Ulf-vom-Mond/ofen/electronics/ofen.kicad_pcb

## KiCad design electronics/ofen.kicad_pcb (2021-03-20)

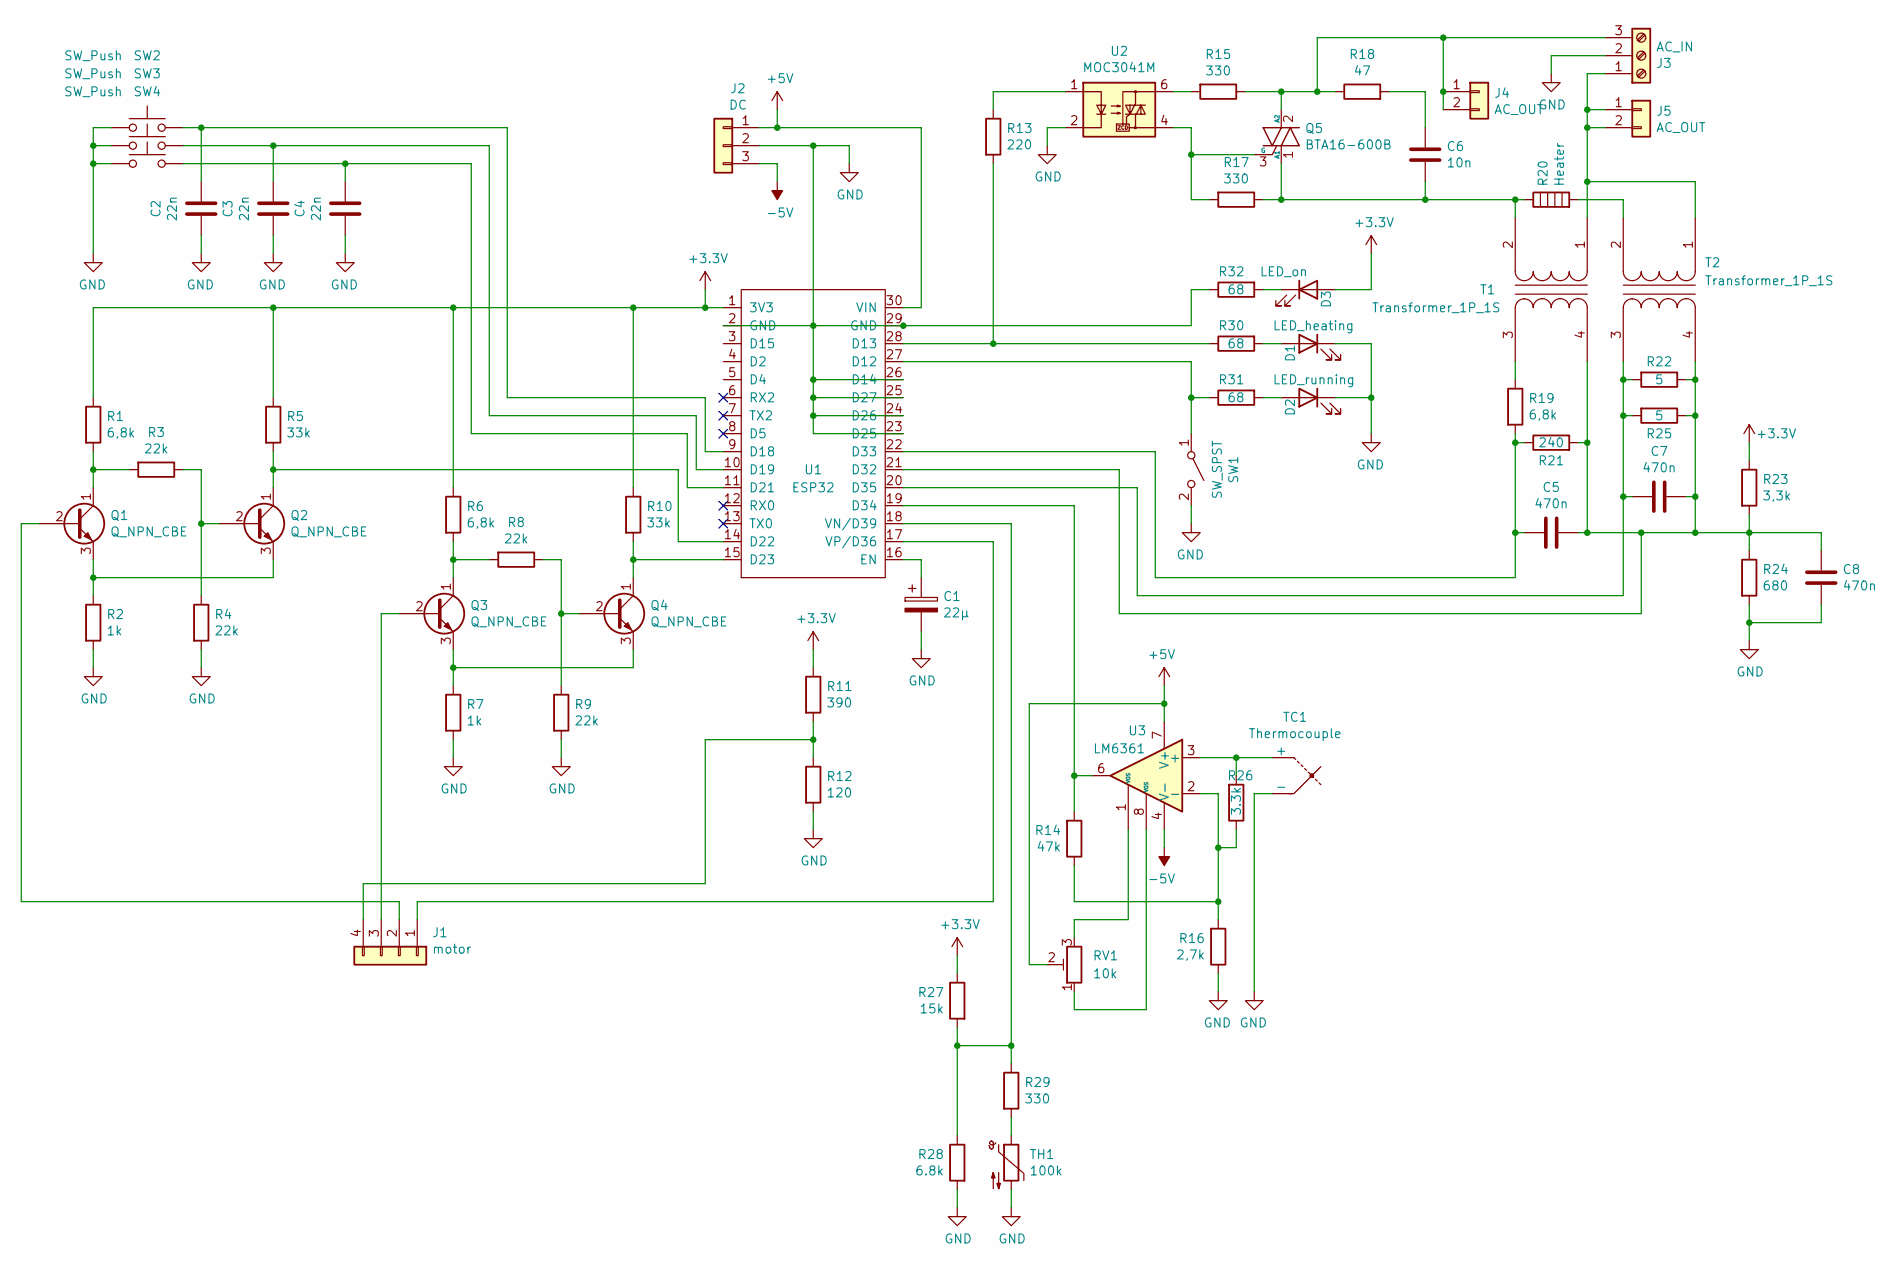
[picture p1: schematic ofen.sch]

Parts:
C1: 22µ; CP_Radial_D6.3mm_P2.50mm
C2, C3, C4: 22n; C_Disc_D4.3mm_W1.9mm_P5.00mm
C5, C7, C8: 470n; C_Rect_L7.0mm_W4.5mm_P5.00mm
C6: 10n; C_Rect_L11.5mm_W3.5mm_P10.00mm_MKT
D1: LED_heating; PinHeader_1x02_P2.54mm_Vertical
D2: LED_running; PinHeader_1x02_P2.54mm_Vertical
D3: LED_on; PinHeader_1x02_P2.54mm_Vertical
J1: motor; PinHeader_1x04_P2.54mm_Vertical
J2: DC; PinHeader_1x03_P2.54mm_Vertical
J3: AC_IN; TerminalBlock_Altech_AK300-3_P5.00mm
J4, J5: AC_OUT; SolderWire-0.75sqmm_1x02_P4.8mm_D1.25mm_OD2.3mm
Q1, Q2, Q3, Q4: Q_NPN_CBE; TO-92L_Inline_Wide
Q5: BTA16-600B; SolderWire-0.75sqmm_1x03_P4.8mm_D1.25mm_OD2.3mm
R1, R6, R19: 6,8k; R_Axial_DIN0207_L6.3mm_D2.5mm_P10.16mm_Horizontal
R2, R7: 1k; R_Axial_DIN0207_L6.3mm_D2.5mm_P10.16mm_Horizontal
R3, R4, R8, R9: 22k; R_Axial_DIN0207_L6.3mm_D2.5mm_P10.16mm_Horizontal
R5, R10: 33k; R_Axial_DIN0207_L6.3mm_D2.5mm_P10.16mm_Horizontal
R11: 390; R_Axial_DIN0207_L6.3mm_D2.5mm_P10.16mm_Horizontal
R12: 120; R_Axial_DIN0207_L6.3mm_D2.5mm_P10.16mm_Horizontal
R13: 220; R_Axial_DIN0207_L6.3mm_D2.5mm_P10.16mm_Horizontal
R14: 47k; R_Axial_DIN0207_L6.3mm_D2.5mm_P10.16mm_Horizontal
R15, R17, R29: 330; R_Axial_DIN0207_L6.3mm_D2.5mm_P10.16mm_Horizontal
R16: 2,7k; R_Axial_DIN0207_L6.3mm_D2.5mm_P10.16mm_Horizontal
R18: 47; R_Axial_DIN0207_L6.3mm_D2.5mm_P10.16mm_Horizontal
R20: Heater; TerminalBlock_Altech_AK300-3_P5.00mm
R21: 240; R_Axial_DIN0207_L6.3mm_D2.5mm_P10.16mm_Horizontal
R22, R25: 5; R_Axial_DIN0207_L6.3mm_D2.5mm_P10.16mm_Horizontal
R23: 3,3k; R_Axial_DIN0207_L6.3mm_D2.5mm_P10.16mm_Horizontal
R24: 680; R_Axial_DIN0207_L6.3mm_D2.5mm_P10.16mm_Horizontal
R26: 3.3k; R_Axial_DIN0207_L6.3mm_D2.5mm_P10.16mm_Horizontal
R27: 15k; R_Axial_DIN0207_L6.3mm_D2.5mm_P10.16mm_Horizontal
R28: 6.8k; R_Axial_DIN0207_L6.3mm_D2.5mm_P10.16mm_Horizontal
R30, R31, R32: 68; R_Axial_DIN0207_L6.3mm_D2.5mm_P10.16mm_Horizontal
RV1: 10k; Potentiometer_Bourns_3296W_Vertical
SW1: SW_SPST; PinHeader_1x02_P2.54mm_Vertical
SW2, SW3, SW4: SW_Push; PinHeader_1x02_P2.54mm_Vertical
T1, T2: Transformer_1P_1S; SolderWire-0.75sqmm_1x04_P4.8mm_D1.25mm_OD2.3mm
TC1: Thermocouple; PinHeader_1x02_P2.54mm_Vertical
TH1: 100k; PinHeader_1x02_P2.54mm_Vertical
U1: ESP32; ESP32-DevModule
U2: MOC3041M; DIP-6_W7.62mm_Socket_LongPads
U3: LM6361; DIP-8_W7.62mm_Socket_LongPads

Connections:
+3V3: D3.2 (A), R1.1, R5.1, R6.1, R10.1, R11.1, R23.1, R27.1, U1.1 (3V3)
+5V: J2.1, RV1.2, U1.30 (VIN), U3.7 (V+)
-5V: J2.3, U3.4 (V-)
GND: C1.2, C2.1, C3.1, C4.1, C8.1, D1.1 (K), D2.1 (K), J2.2, J3.2, R2.2, R4.2, R7.2, R9.2, R12.2, R16.1, R24.2, R28.2, R32.1, SW1.2 (B), SW2.2, SW3.2, SW4.2, TC1.2 (-), TH1.2, U1.2 (GND), U1.23 (D25), U1.24 (D26), U1.25 (D27), U1.26 (D14), U1.29 (GND), U2.2; also elsewhere on the board
unnamed: C1.1, U1.16 (EN)
unnamed: C2.2, SW2.1, U1.9 (D18)
unnamed: C3.2, SW3.1, U1.10 (D19)
unnamed: C4.2, SW4.1, U1.11 (D21)
unnamed: C5.1, C7.1, C8.2, R21.2, R22.1, R23.2, R24.1, R25.1, T1.4 (SB), T2.4 (SB), U1.21 (D32)
unnamed: C5.2, R19.2, R21.1, U1.22 (D33)
unnamed: C6.1, R18.2
unnamed: C6.2, Q5.1 (A1), R17.1, R20.1, T1.2 (AB)
unnamed: C7.2, R22.2, R25.2, T2.3 (SA), U1.20 (D35)
unnamed: D1.2 (A), R30.2
unnamed: D2.2 (A), R31.2
unnamed: D3.1 (K), R32.2
unnamed: J1.1, U1.17 (VP/D36)
unnamed: J1.2, Q1.2 (B)
unnamed: J1.3, Q3.2 (B)
unnamed: J1.4, R11.2, R12.1
unnamed: J3.1, J5.1, J5.2, T1.1 (AA), T2.1 (AA)
unnamed: J3.3, J4.1, J4.2, Q5.2 (A2), R15.1, R18.1
unnamed: Q1.1 (C), R1.2, R3.2
unnamed: Q1.3 (E), Q2.3 (E), R2.1
unnamed: Q2.1 (C), R5.2, U1.14 (D22)
unnamed: Q2.2 (B), R3.1, R4.1
unnamed: Q3.1 (C), R6.2, R8.2
unnamed: Q3.3 (E), Q4.3 (E), R7.1
unnamed: Q4.1 (C), R10.2, U1.15 (D23)
unnamed: Q4.2 (B), R8.1, R9.1
unnamed: Q5.3 (G), R17.2, U2.4
unnamed: R13.1, U2.1
unnamed: R13.2, R30.1, U1.28 (D13)
unnamed: R14.1, R16.2, R26.1, U3.2 (-)
unnamed: R14.2, U1.19 (D34), U3.6
unnamed: R15.2, U2.6
unnamed: R19.1, T1.3 (SA)
unnamed: R20.2, T2.2 (AB)
unnamed: R26.2, TC1.1 (+), U3.3 (+)
unnamed: R27.2, R28.1, R29.1, U1.18 (VN/D39)
unnamed: R29.2, TH1.1
unnamed: R31.1, SW1.1 (A), U1.27 (D12)
unnamed: RV1.1, U3.8 (VOS)
unnamed: RV1.3, U3.1 (VOS)

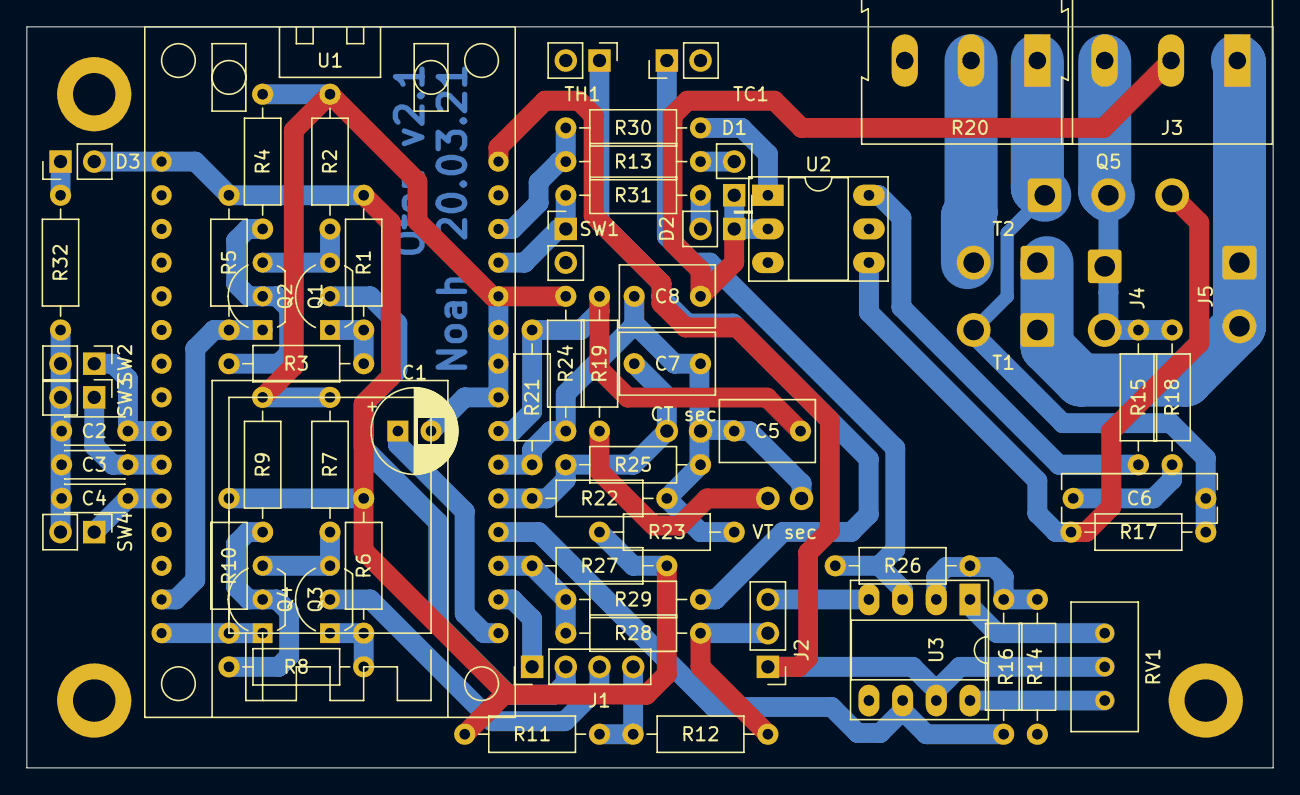
[picture p2: board ofen.kicad_pcb from above]

Board: 2 copper layers, 94.0 x 55.9 mm, 68 parts (0 on the bottom side), 44 nets.

Other parts of the board:
 : MountingHole_3.2mm_M3_DIN965_Pad
 #2,  #3: MountingHole_3.2mm_M3_DIN965_Pad

Their connections:
GND: .1, #2.1, #3.1; also elsewhere on the board
