Ulf-vom-Mond/ofen/(commit log)

2020-11-15 first part of the display works (time, temperature and power display)
2020-12-31 fixed severer bugs with drawing of graph and table and with changing values
    [ofen.ino]
2021-01-01 dont hate myself anymore. fixed a lo of terrible things. Significant changes: PID prepared, PWM works, On/Off seems to work, on-time timer is counting, setting temp according to setpoints works
    [ofen.ino]
2021-01-09 everything broken now
    [ofen.kicad_pcb, ofen.sch]
2021-01-18 this is a working, but not very usable version
    [ofen.kicad_pcb, ofen.sch]
2021-01-22 fixed crashing when turning the knob, improved setpoint deletion
    [ofen.ino]
2021-01-24 introduced serial commands and pid autotune. should be more or less finished now. missing: thermocouple reference temperature compensation, finetuning of temp and power reading
    [ofen.ino]
2021-01-25 made a PCB
    [ofen.sch]
2021-01-26 increased ground zone clearance to 0.8mm, updated KiCad version to 5.1.9
    [ofen.kicad_pcb]
2021-01-26 added resistor in parallel to the thermocouple to prevent OpAmp from destroying the ESP32
    [ofen.kicad_pcb, ofen.sch]
2021-01-28 arranged silkscreen and symbols properly
    [ofen.kicad_pcb]
2021-02-03 updated gpio configuration according to PCB
2021-03-13 added opamp offset trimmer to schematic and pcb
    [ofen.kicad_pcb, ofen.sch]
2021-03-13 redid adc calibration and some small changes
    [ofen.sch]
2021-03-16 added cold junction compensation and three status leds
    [ofen.kicad_pcb, ofen.sch]
2021-03-18 redesigned PCB. smaller, better, double layer
    [ofen.kicad_pcb, ofen.sch]
2021-03-20 removed front GND pour on PCB
    [ofen.kicad_pcb, ofen.sch]
2021-03-21 added constantOutput command, improved current and voltage measurement, fixed setpoint save bug
    [ofen.ino]
